leomelli32/Enceinte-Bluetooth-TPA3110D2/librairies/CWF1612A-R10K/3D/CWF1612A-R10K.stp

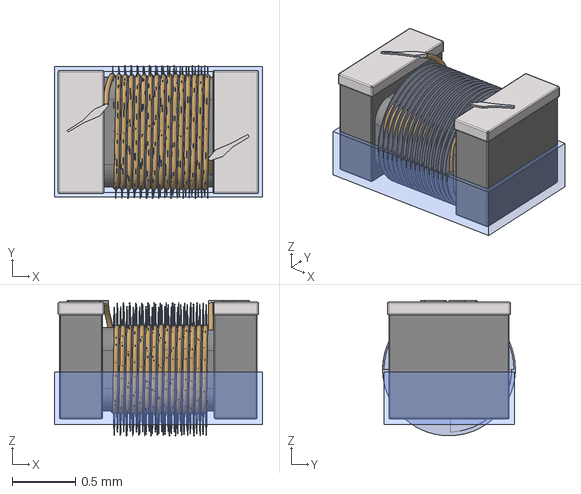
[picture p7: CAD file, 2026-03-25]
librairies/CWF1612A-R10K/3D/CWF1612A-R10K.stp
1.64 x 1.05 x 1.07 mm
