leomelli32/Enceinte-Bluetooth-TPA3110D2/librairies/L7805/L7805.step

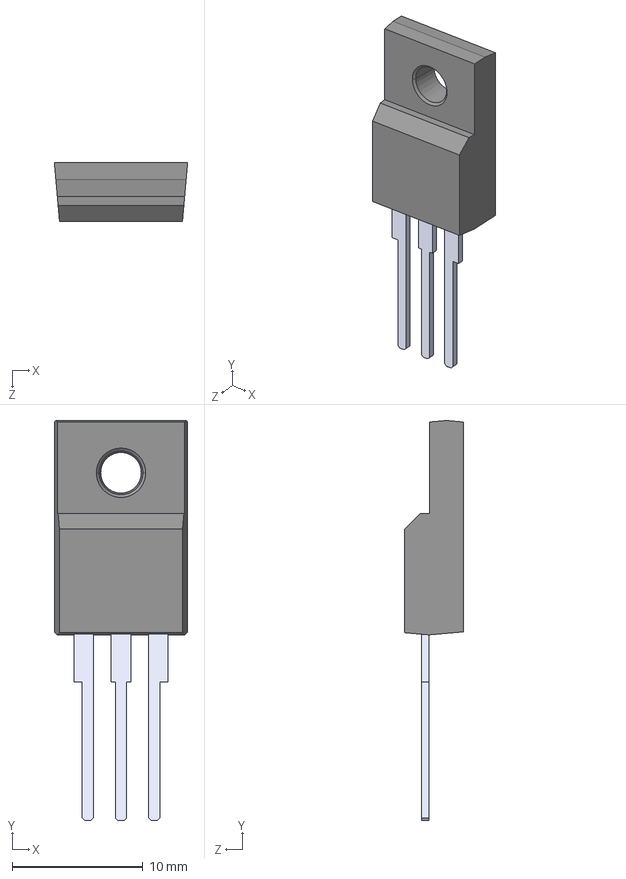
[picture p8: CAD file, 2026-03-14]
librairies/L7805/L7805.step
10.2 x 30.6 x 4.50 mm
