leomelli32/Enceinte-Bluetooth-TPA3110D2/librairies/SRN5040-150M/3D/SRN5040-150M.stp

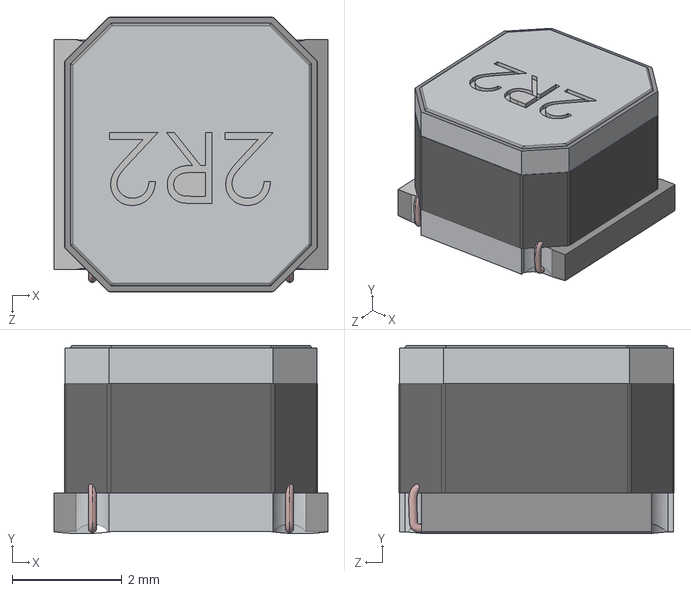
[picture p9: CAD file, 2026-03-25]
librairies/SRN5040-150M/3D/SRN5040-150M.stp
5.00 x 3.44 x 5.02 mm
