leomelli32/Enceinte-Bluetooth-TPA3110D2/librairies/TB6612FNG,C,8,EL/3D/TB6612FNG,C,8,EL.stp

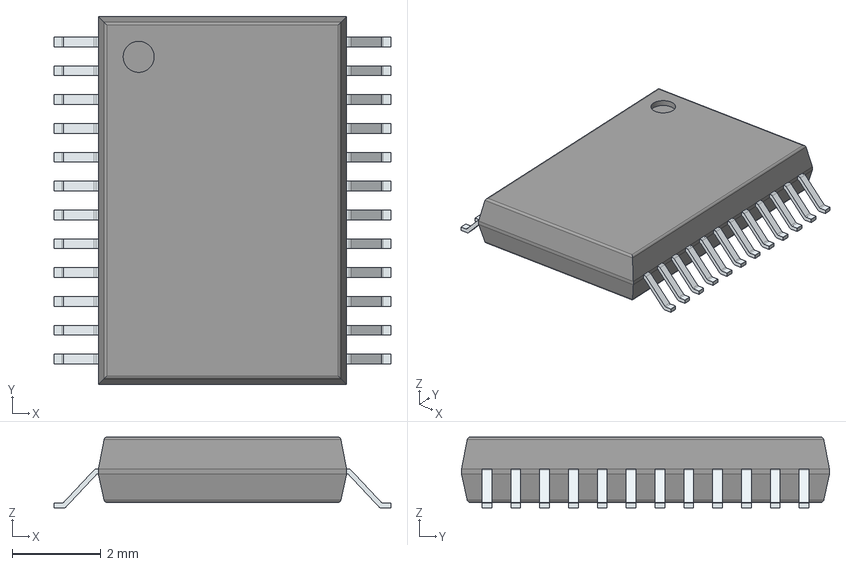
[picture p10: CAD file, 2026-03-12]
librairies/TB6612FNG,C,8,EL/3D/TB6612FNG,C,8,EL.stp
7.60 x 8.30 x 1.60 mm
PinsArrayLR
