leomelli32/Enceinte-Bluetooth-TPA3110D2/librairies/buck/premier/MP008288/3D/MP008288.stp

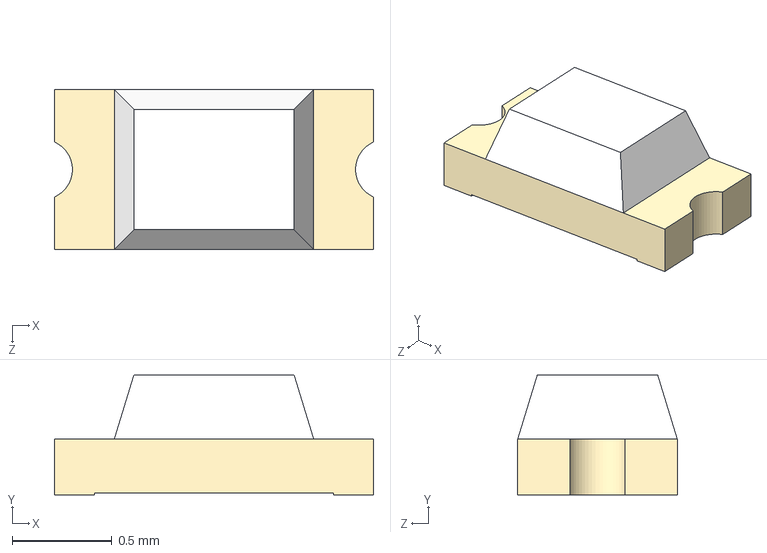
[picture p12: CAD file, 2026-03-12]
librairies/buck/premier/MP008288/3D/MP008288.stp
1.60 x 0.6 x 0.8 mm
