leomelli32/Enceinte-Bluetooth-TPA3110D2/(list of files, drawings)

Other design files:
librairies/buck/premier/MP008288/Altium/LEDC1608X60N.PcbLib
librairies/buck/premier/MP008288/Altium/MP008288.SchLib
librairies/CWF1612A-R10K/Altium/CWF1612A100J.PcbLib
librairies/CWF1612A-R10K/Altium/CWF1612A-R10K.SchLib
librairies/TB6612FNG,C,8,EL/Altium/SOP65P760X160-24N.PcbLib
librairies/TB6612FNG,C,8,EL/Altium/TB6612FNG_C_8_EL.SchLib
librairies/TPA3110D2PWPR/Altium/SOP65P640X120-29N.PcbLib
librairies/TPA3110D2PWPR/Altium/TPA3110D2PWPR.SchLib
