leomelli32/Enceinte-Bluetooth-TPA3110D2/Enceinte/Enceinte.kicad_pcb

## KiCad design Enceinte/Enceinte.kicad_pcb (2026-03-30)

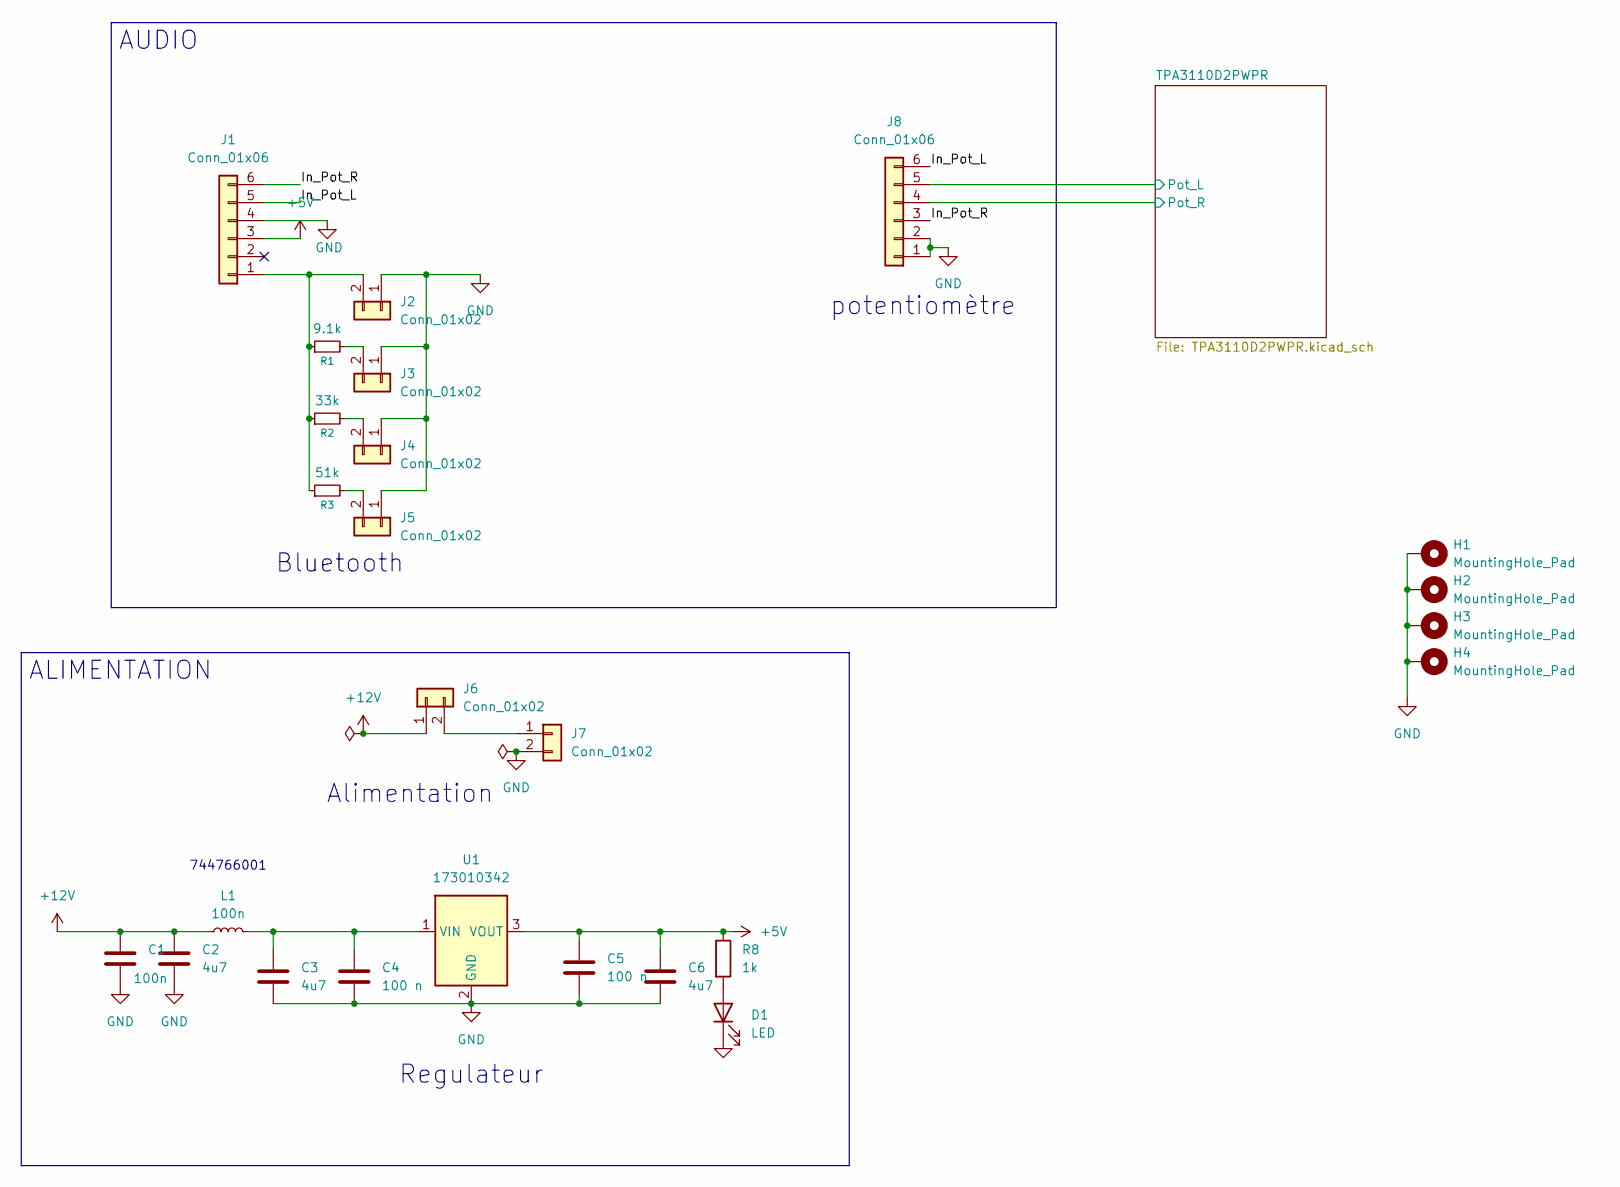
[picture p13: schematic Enceinte.kicad_sch]

Parts:
C1: 100n; C_0603_1608Metric
C2, C3, C6: 4u7; C_0603_1608Metric
C4, C5: 100 n; C_0603_1608Metric
D1: LED; LED_0603_1608Metric
H1, H2, H3, H4: MountingHole_Pad; MountingHole_2.5mm_Pad
J1, J8: Conn_01x06; JST_XH_B6B-XH-A_1x06_P2.50mm_Vertical
J2, J3, J4, J5, J6, J7: Conn_01x02; JST_XH_B2B-XH-A_1x02_P2.50mm_Vertical
L1: 100n; L_Wuerth_HCI-5040
R1: 9.1k; R_0603_1608Metric
R2: 33k; R_0603_1608Metric
R3: 51k; R_0603_1608Metric_Pad0.98x0.95mm_HandSolder
R8: 1k; R_0402_1005Metric
U1: 173010342; U_Wurth_MagIC-FDSM_173010x42

Connections:
+5V: C5.1, C6.1, J1.3, R8.1, U1.3 (VOUT)
+12V: C1.2, C2.1, J6.1, L1.1; also elsewhere on the board
/In_Pot_L: J1.5, J8.6
/In_Pot_R: J1.6, J8.3
/TPA3110D2PWPR/Pot_L: J8.5; also elsewhere on the board
/TPA3110D2PWPR/Pot_R: J8.4; also elsewhere on the board
GND: C1.1, C2.2, C3.2, C4.2, C5.2, C6.2, D1.1 (K), H1.1, H2.1, H3.1, H4.1, J1.4, J2.1, J3.1, J4.1, J5.1, J7.2, J8.1, J8.2, U1.2 (GND); also elsewhere on the board
unnamed: D1.2 (A), R8.2
unnamed: J1.1, J2.2, R1.1, R2.1, R3.1
unnamed: J3.2, R1.2
unnamed: J4.2, R2.2
unnamed: J5.2, R3.2
unnamed: J6.2, J7.1
unnamed: C3.1, C4.1, L1.2, U1.1 (VIN)

Notes on the sheet:
Regulateur
Alimentation
potentiomètre
Bluetooth
744766001
AUDIO
ALIMENTATION

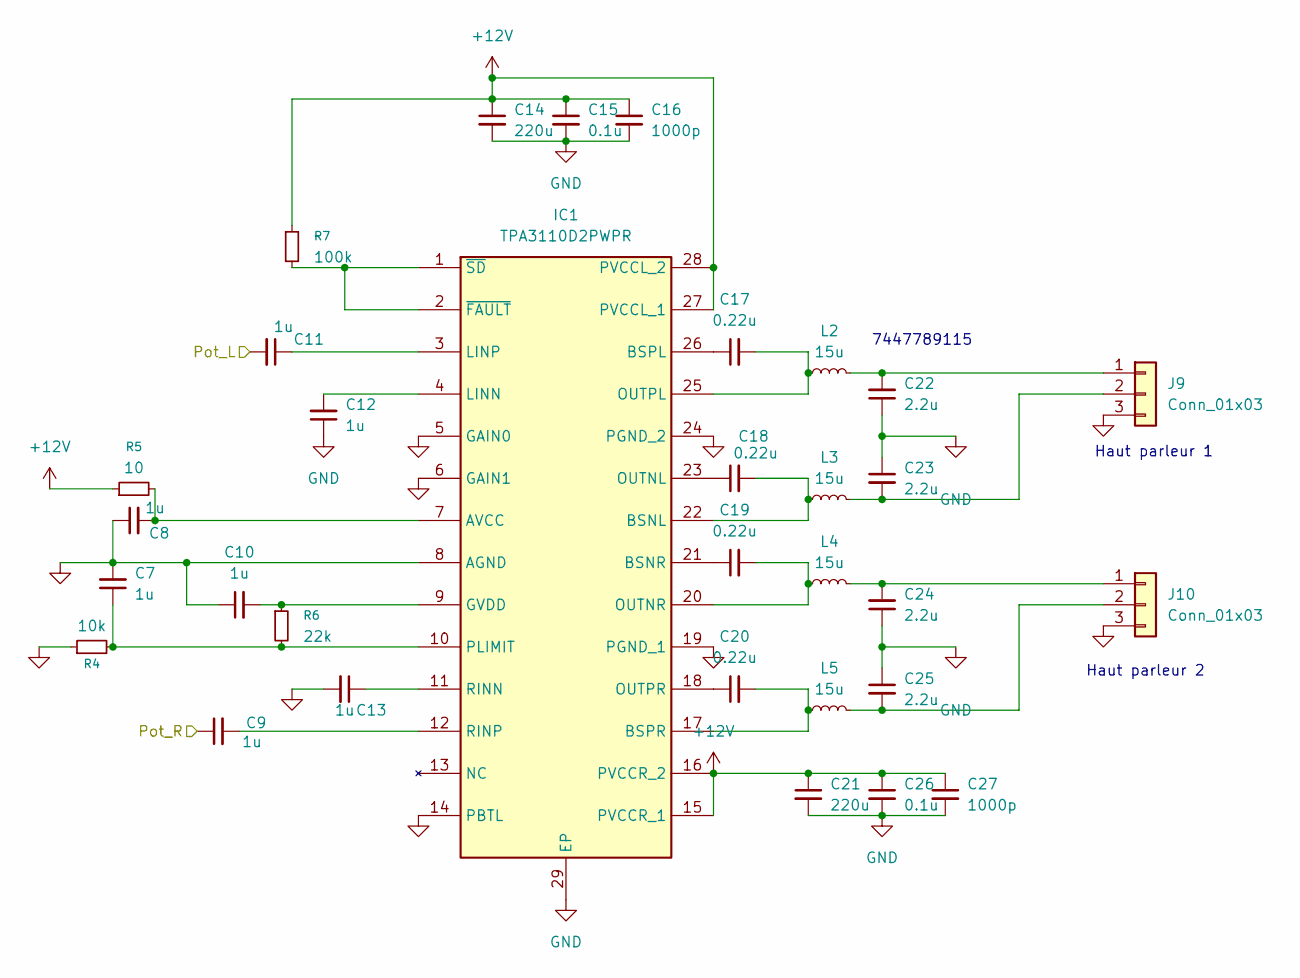
[picture p14: schematic TPA3110D2PWPR.kicad_sch]

Parts:
C7, C8, C9, C10, C11, C12, C13: 1u; C_0603_1608Metric
C14, C21: 220u; CP_Elec_6.3x7.7
C15, C26: 0.1u; C_0603_1608Metric
C16, C27: 1000p; C_0603_1608Metric
C17, C18, C19, C20: 0.22u; C_0603_1608Metric
C22, C23, C24, C25: 2.2u; C_0603_1608Metric
IC1: TPA3110D2PWPR; SOP65P640X120-29N; Mouser Part Number 595-TPA3110D2PWPR
J9, J10: Conn_01x03; JST_XH_B3B-XH-A_1x03_P2.50mm_Vertical
L2, L3, L4, L5: 15u; L_Wuerth_WE-PD-Typ-7345
R4: 10k; R_0603_1608Metric
R5: 10; R_0603_1608Metric
R6: 22k; R_0603_1608Metric
R7: 100k; R_0603_1608Metric

Connections:
+12V: C14.1, C15.1, C16.1, C21.1, C26.1, C27.1, IC1.15 (PVCCR_1), IC1.16 (PVCCR_2), IC1.27 (PVCCL_1), IC1.28 (PVCCL_2), R5.1, R7.1; also elsewhere on the board
/TPA3110D2PWPR/Pot_L: C11.2; also elsewhere on the board
/TPA3110D2PWPR/Pot_R: C9.1; also elsewhere on the board
GND: C7.2, C8.1, C10.1, C12.1, C13.2, C14.2, C15.2, C16.2, C21.2, C22.1, C23.1, C24.1, C25.1, C26.2, C27.2, IC1.5 (GAIN0), IC1.6 (GAIN1), IC1.8 (AGND), IC1.14 (PBTL), IC1.19 (PGND_1), IC1.24 (PGND_2), IC1.29 (EP), J9.3, J10.3, R4.1; also elsewhere on the board
unnamed: C8.2, IC1.7 (AVCC), R5.2
unnamed: C18.2, IC1.22 (BSNL), L3.1
unnamed: C19.1, IC1.21 (BSNR)
unnamed: C17.1, IC1.26 (BSPL)
unnamed: C20.2, IC1.17 (BSPR), L5.1
unnamed: C10.2, IC1.9 (GVDD), R6.1
unnamed: C12.2, IC1.4 (LINN)
unnamed: C11.1, IC1.3 (LINP)
unnamed: C18.1, IC1.23 (OUTNL)
unnamed: C19.2, IC1.20 (OUTNR), L4.1
unnamed: C17.2, IC1.25 (OUTPL), L2.1
unnamed: C20.1, IC1.18 (OUTPR)
unnamed: C7.1, IC1.10 (PLIMIT), R4.2, R6.2
unnamed: C13.1, IC1.11 (RINN)
unnamed: C9.2, IC1.12 (RINP)
unnamed: IC1.1 (~SD), IC1.2 (~FAULT), R7.2
unnamed: C22.2, J9.1, L2.2
unnamed: C23.2, J9.2, L3.2
unnamed: C24.2, J10.1, L4.2
unnamed: C25.2, J10.2, L5.2

Notes on the sheet:
Haut parleur 2
7447789115
Haut parleur 1

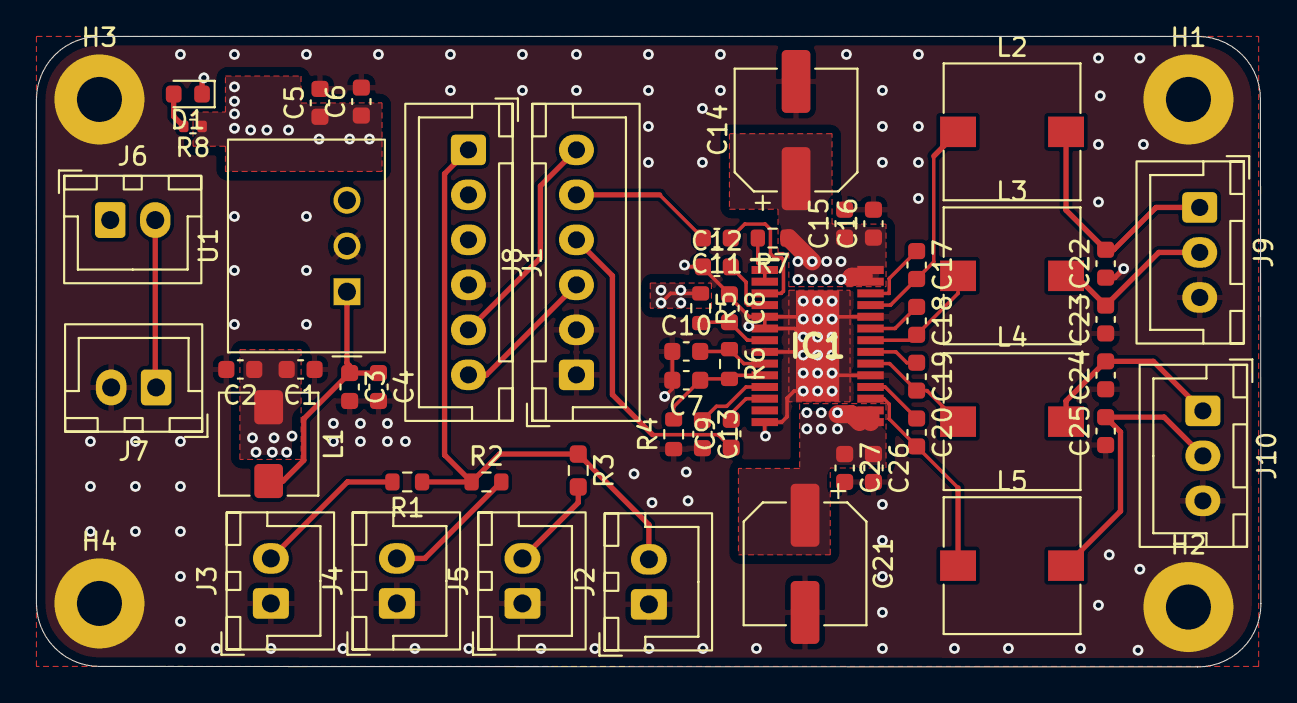
[picture p15: board Enceinte.kicad_pcb from above]

Board: 4 copper layers, 68.0 x 35.0 mm, 57 parts (0 on the bottom side), 34 nets.
