leomelli32/Enceinte-Bluetooth-TPA3110D2/librairies/buck/premier/premier.kicad_pcb

## KiCad design librairies/buck/premier/premier.kicad_pcb (2026-03-12)

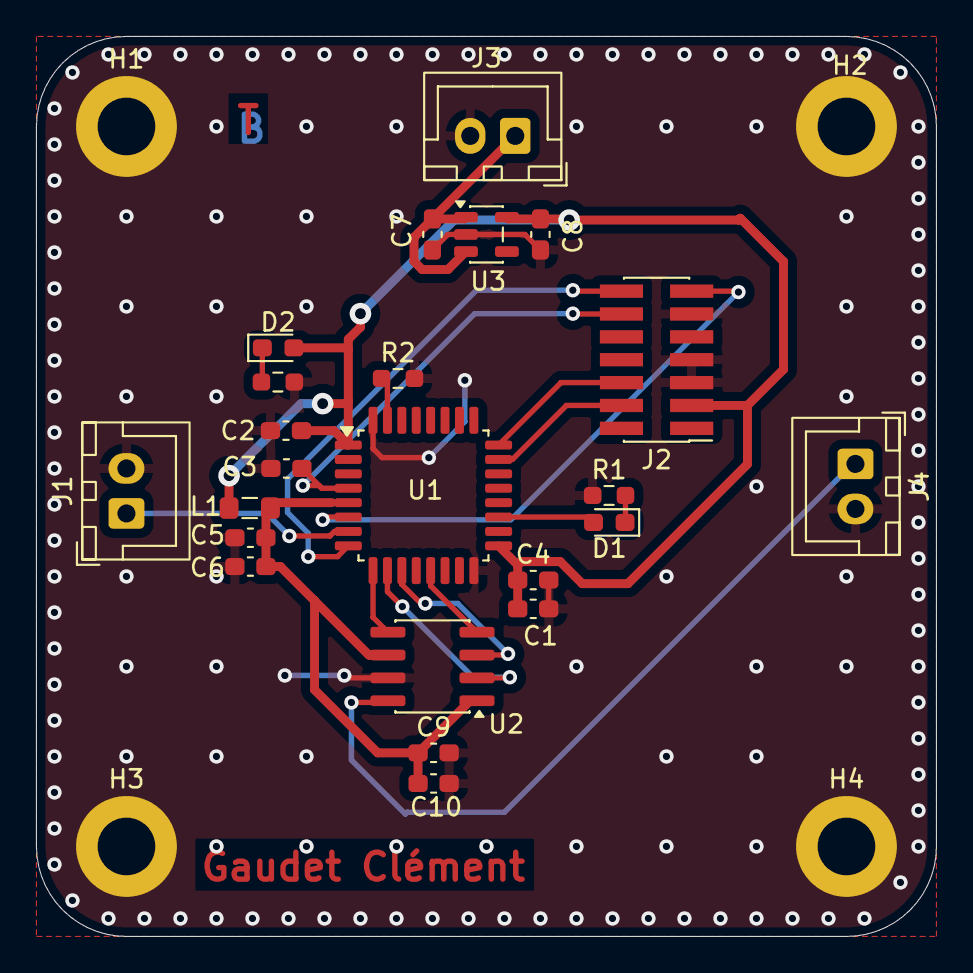
[picture p16: board premier.kicad_pcb from above]

Board: 2 copper layers, 50.0 x 50.0 mm, 27 parts (0 on the bottom side), 19 nets.

Parts:
C1: 4u7; C_0603_1608Metric_Pad1.08x0.95mm_HandSolder
C2, C3, C4, C9: 100n; C_0603_1608Metric_Pad1.08x0.95mm_HandSolder
C5: 1u; C_0603_1608Metric_Pad1.08x0.95mm_HandSolder
C6, C10: 10n; C_0603_1608Metric_Pad1.08x0.95mm_HandSolder
C7, C8: 1uF; C_0603_1608Metric_Pad1.08x0.95mm_HandSolder
D1, D2: LED_Small; LED_0603_1608Metric_Pad1.05x0.95mm_HandSolder
H1, H2, H3, H4: MountingHole_Pad; MountingHole_3.2mm_M3_DIN965_Pad
J1, J3, J4: Conn_01x02; JST_XH_B2B-XH-A_1x02_P2.50mm_Vertical
J2: Conn_02x07_Odd_Even; PinHeader_2x07_P1.27mm_Vertical_SMD
L1: 39n; L_0805_2012Metric_Pad1.05x1.20mm_HandSolder
R1, R3: 1k; R_0603_1608Metric_Pad0.98x0.95mm_HandSolder
R2: 100k; R_0603_1608Metric_Pad0.98x0.95mm_HandSolder
U1: STM32L021K4Tx; LQFP-32_7x7mm_P0.8mm
U2: MCP4801; SOIC-8_3.9x4.9mm_P1.27mm
U3: BU33SD5WG-TR; SOT-23-5

Connections:
+3.3V: C1.1, C2.1, C4.1, C8.1, D2.2 (A), J2.3, L1.1, U1.1 (VDD), U1.17 (VDD), U3.5 (VOUT)
+3.3VA: C5.1, C6.1, C9.1, C10.1, L1.2, U1.5 (VDDA), U2.1 (Vdd), U2.6 (~SHDN)
+5V: C7.1, J3.1, U3.1 (VIN), U3.3 (~SHDN)
ADC_IN1: J1.1, U1.7 (PA1)
DAC_OUT: J4.1, U2.8 (Vout)
DAC_nCS: U1.10 (PA4), U2.2 (~CS)
DAC_nLDAC: U1.9 (PA3), U2.5 (~LDAC)
GND: C1.2, C2.2, C3.2, C4.2, C5.2, C6.2, C7.2, C8.2, C9.2, C10.2, H1.1, H2.1, H3.1, H4.1, J1.2, J2.5, J2.7, J2.11, J3.2, J4.2, R1.1, R2.2, R3.1, U1.16 (VSS), U1.32 (VSS), U2.7 (Vss), U3.2 (GND)
LED_STATUS: D1.2 (A), U1.19 (PA9)
NRST: C3.1, J2.12, U1.4 (NRST)
unnamed: D1.1 (K), R1.2
unnamed: D2.1 (K), R3.2
unnamed: R2.1, U1.31 (PB9)
SPI1_MOSI: U1.13 (PA7), U2.4 (SDI)
SPI1_SCK: U1.11 (PA5), U2.3 (SCK)
SWDCK: J2.6, U1.24 (PA14)
SWDIO: J2.4, U1.23 (PA13)
USART2_RX: J2.13, U1.6 (PA0)
USART2_TX: J2.14, U1.8 (PA2)
