leomelli32/Enceinte-Bluetooth-TPA3110D2/(commit log)

2026-03-12 Importation du kicad
    [EDI2CAP.CFG, Enceinte.kicad_pcb, Enceinte.kicad_sch, LEDC1608X60N.PcbLib, MP008288.SchLib, MP008288.stp, SOP65P640X120-29N.PcbLib, SOP65P760X160-24N.PcbLib]
2026-03-12 Routage terminé
    [Enceinte.kicad_pcb, Enceinte.kicad_sch, TPA3110D2PWPR.kicad_sch]
2026-03-14 Changement régulateur de tension
    [Enceinte.kicad_pcb, Enceinte.kicad_sch, L7805.step]
2026-03-16 correction des bordures
    [Enceinte.kicad_pcb]
2026-03-16 des changements sont à faire
    [Enceinte.kicad_pcb, Enceinte.kicad_sch, TPA3110D2PWPR.kicad_sch]
2026-03-20 doc latex
    [Enceinte.kicad_pcb, Enceinte.kicad_sch, TPA3110D2PWPR.kicad_sch]
2026-03-25 nouvelles inductances
    [CWF1612A-R10K.SchLib, CWF1612A-R10K.stp, CWF1612A100J.PcbLib, EDI2CAP.CFG, Enceinte.kicad_pcb, Enceinte.kicad_sch, SRN5040-150M.stp, TPA3110D2PWPR.kicad_sch]
2026-03-30 indu Wurth
    [Enceinte.kicad_pcb, Enceinte.kicad_sch, TPA3110D2PWPR.kicad_sch]
